begoon/gmc4-loader/README.markdown

Schematic
=========



More information
================

[A blog post about the loader][GMC4 loader assembled].

[GMC4 loader assembled]: http://demin.ws/blog/english/2012/07/25/gmc4-loader-assembled/
