begoon/gmc4-loader/(commit log)

2012-07-25 Added Eagle schematic and library.
    [GMC-4 UBW Loader.sch]
2012-08-21 Added README with links to video, schematic and the blog post.
